doge4096/smart_home_esp8266/docs/05-testing.md

# 05 测试与分析

## 1. 测试对象

我把测试分成两个阶段：

1. **雏形设备**：只做声控开关灯，用于验证语音识别与舵机结构的可行性；
2. **改进版设备**：增加环境采集、APP 控制、自动关灯，安装到卧室做长期测试。

我把改进版在卧室实际安装并连续运行了 **4 个月**，期间保持正常生活使用，不做特殊维护。这 4 个月是集中记录的测试期；之后设备没有收起来，继续当日常设备使用，累计约 **一年半**。

## 2. 测试项目与结果

### 2.1 语音识别

| 项目 | 条件 | 结果 |
| --- | --- | --- |
| 识别距离 | 4 米以内 | 正常识别 |
| 口音 | 接近标准的普通话 | 正常识别 |
| 环境 | 室内日常噪声 | 未出现明显误触发 |

HLK-V20 的关键词在模块配置网页中设定，识别结果通过串口输出。相比我早期试用的 DFRobot 语音模块，HLK-V20 的识别准确率更高。

### 2.2 手动开关兼容

分控端只是用舵机拨动原有开关，不改变线路。测试期间我手动按压开关，不受影响；舵机停在非动作角度时也不会阻挡手动操作。

### 2.3 舵机固定与按压

| 阶段 | 固定方式 | 现象 |
| --- | --- | --- |
| 初版 | 玻璃胶直接粘舵机 | 长期使用后低概率出现粘连不牢，按压失败 |
| 改进版 | 加装专用拨片结构 + 支架 | 测试期间未再出现按压失败 |

我分析的原因是胶体老化后舵机位置偏移，加上舵机臂与开关表面摩擦力不足。拨片结构把旋转运动转为推压，减小了所需力度，同时用支架限制位移。

### 2.4 自动关灯

分控端联网获取时间，每天到达设定时间（如上午 10 点）时判断一次亮度：

- 亮度低于阈值 → 自动关灯；
- 亮度高于阈值 → 保持原状。

阈值通过 APP 下发“设置阈值”命令写入，取的是点击那一刻光敏电阻的读数。测试中我发现低成本光敏电阻的绝对精度有限，固定阈值在不同季节会误判，因此最终依靠“阈值调整 + 人工干预”来避免误动作。

### 2.5 APP 数据查看

APP 连接后可以查看两个房间的温度、湿度、可燃气体浓度。下图是实际使用时的界面：

APP 数据查看

- 卧室开了空调，温度 27.7°C、湿度 76.4%；
- 客厅未开空调，温度 28.4°C；
- 客厅刚做完饭，可燃气体读数 27，明显高于卧室的 4。

点击“刷新室内数据”可以主动请求一次上报；不操作时，主控端按 5 分钟周期定时上报，APP 会持续收到数据。

### 2.6 APP 灯具控制

控制界面按房间分组，显示当前灯的状态，支持开灯、关灯和刷新亮度。测试中我可以分别控制卧室与客厅的灯，状态显示与实际一致。

APP 灯具控制

### 2.7 长期运行

4 个月记录期间，我记录到：

- 语音开关灯正常，未影响手动开关；
- 主控端定时上报与 APP 刷新正常；
- 自动关灯按设定时间执行；
- 未出现死机或需要重启的情况。

记录期结束后，设备继续在日常使用，累计使用约 **一年半**，期间没有出现故障。后来我更换了住址，新住处没有这个需求，设备才停用。

## 3. 问题与处理

| 问题 | 原因 | 处理 |
| --- | --- | --- |
| 舵机按压失败 | 玻璃胶老化、舵机位移、摩擦力不足 | 加装专用拨片与支架，减小按压力度 |
| 自动关灯误判 | 光敏电阻精度低、季节光照变化 | APP 可调阈值，配合人工干预 |
| 主控端体积大 | STM32C8T6 核心板占用面积 | 未彻底解决，改用贴片方案可缩小 |
| 只能控制单个开关 | 一个分控对应一个舵机 | 连排开关需要多个分控，成本上升 |
| 功能单一 | 只做了灯光与空调 | 预留了扩展接口，未继续开发 |

## 4. 结果分析

系统达到了我当初设定的设计目标。回到设计初衷——住在出租屋，躺下后不想再起床关灯——这一点在一年半的日常使用中一直成立：

- 不改线路、不换面板，分控端插电即用；
- 语音、APP、自动三种控制方式可用；
- 环境数据可以远程查看，异常时标红；
- 连续记录 4 个月，后续累计使用约一年半，稳定性满足日常使用。

不足主要在结构和扩展性：主控端体积偏大，分控端只能控制单个开关，传感器精度依赖现场标定。这些问题在 [06 复盘](06-retrospective.md) 中展开。

## 5. 本章小结

我测试了语音识别、手动兼容、舵机结构、自动关灯、APP 数据与控制、长期运行六个方面。最关键的一次改进是舵机拨片结构：它把“能用”变成了“长期可用”。其余问题属于成本与结构限制，不影响核心功能。
