doge4096/smart_home_esp8266/docs/06-retrospective.md

# 06 复盘

## 0. 项目概述

**做了什么**：在不能改线路、不能换面板的出租屋里，用低成本器件做了一套可用的智能家居系统——STM32 + ESP8266 主控负责语音识别与环境采集，ESP8266 分控用舵机拨动原有开关，阿里云负责消息转发，Android APP 远程查看与控制。

**结果**：设备在卧室连续运行 4 个月完成测试记录，之后继续日常使用，累计约 **一年半**，语音、APP、定时三种控制方式都可用，期间未出现死机或故障；后来更换住址、新住处没有需求，设备才停用。

**我负责的部分**：需求、选型、电路、PCB、结构、固件、云端规则、APP 全部独立完成。

**可以核对的材料**：

- 固件源码：[firmware/](../firmware/)
- PCB 工程：[hardware/](../hardware/)
- 测试记录：[05 测试与分析](05-testing.md)
- 实物与截图：[images/](../images/)

## 1. 关键决策与结果

### 1.1 先定约束，再选方案

**决策**：动手前先给自己定了三条约束——不改线路、不换面板、不破坏墙面。

**结果**：约束直接排除了继电器方案，指向舵机拨开关；整套系统在出租屋场景里真的能用，搬家也能拆走。如果一开始选继电器改线路，后面的长期测试根本不会发生。

**证据**：[01 系统设计 3.4](01-system-design.md) 有舵机与继电器的对比表，分控板实物见 [images/sub-pcb.png](../images/sub-pcb.png)。

### 1.2 用真实环境验证，而不是实验室演示

**决策**：把改进版直接装到卧室，连续跑 4 个月，保持正常生活使用，不做特殊维护；测试记录结束后也没有收起来，继续当日常设备用。

**结果**：暴露了舵机胶粘老化导致的按压失败，推动我把固定方式改成专用拨片 + 支架。这个问题在实验室里按几次是发现不了的。设备累计使用约一年半，没有再出现故障。

**证据**：[05 测试与分析 2.3](05-testing.md) 记录了初版与改进版的对比。

### 1.3 设备解耦：云端广播代替点对点

**决策**：消息发到云端规则引擎，由规则广播到所有相关 topic，设备之间不保存彼此地址。

**结果**：新增一个分控端只需在云端加一条转发规则，不用改主控固件；APP 与分控端能同时收到同一条命令，状态更容易保持一致。

**代价**：消息会发给所有订阅者，但这个系统设备数量少，带宽可以忽略。

**证据**：[01 系统设计 4.2](01-system-design.md)；云端规则配置见 [04 云平台与 APP](04-cloud-and-app.md)。

### 1.4 按需上报

**决策**：环境数据 5 秒轮询、累计 60 次（约 5 分钟）上报一轮；亮度数据只在收到命令时上报。

**结果**：减少了无效上报，降低功耗、流量和云端消息堆积。

**证据**：上报周期写在 [03 固件设计](03-firmware.md) 的主循环里，测试数据见 [05 测试与分析 2.5](05-testing.md)。

## 2. 不足与边界

下面这些问题确实存在，其中大部分没有解决。

### 2.1 主控端体积偏大

我用了 STM32C8T6 核心板，它占用了整块板子的主要面积，外壳只能做大。这是最直观的缺点，照片里也能看出来。

**是否解决**：没有。改用贴片方案可以缩小，但当时没有条件做。

### 2.2 只能控制单个开关

一个分控对应一个舵机、一个开关。家里常见的连排双开/三开面板，需要多个分控，成本和体积都上去了。当时我也没有做多舵机联动。

**是否解决**：没有。需要多路执行器或独立的舵机驱动方案。

### 2.3 传感器精度有限

光敏电阻和 MQ-4 都是我选的低成本模拟器件，绝对精度有限。自动关灯的阈值需要按季节和房间朝向调整，否则会误判。

**是否解决**：部分解决。靠“可调阈值 + 人工干预”兜底，没有做正式标定。

### 2.4 依赖云端，断网能力有限

语音命令的链路是“主控 → 阿里云 → 分控”，断网时语音识别仍然工作，但命令发不到分控。自动关灯的判断虽然写在分控本地，但触发入口是 MQTT 消息回调，断网时同样不会执行。这是我在架构上留下的一个明显短板。

**是否解决**：没有。如果重做，我会用 ESP-NOW 或局域网 broker 做本地兜底。

### 2.5 当时没有用版本管理

毕业设计期间，我的代码只保存在本地工程里，没有用 Git 管理，也没有远程备份，两个房间的固件靠文件夹名区分。整理仓库时我把固件和 PCB 工程补了进来，但 Android APP 的源码没有找到，只能保留设计说明。

**是否解决**：已补。归档时把固件、PCB、文档纳入 Git，并修正了文档与源码不一致的地方：

| 项目 | 论文/初版文档 | 源码与实物 |
| --- | --- | --- |
| 温湿度传感器 | DHT20 | AHT20 |
| 自动关灯 | 亮度低于设定值则关灯 | 一致，但触发条件受限（见下） |
| 上报周期 | 约 3 分钟 | 5 秒 × 60 = 5 分钟 |
| APP 端定时数据 | 约 10 分钟一次 | 跟随主控 5 分钟周期 |

### 2.6 自动关灯的实现缺陷

我把自动关灯的判断写成了“早上 10 点、亮度低于阈值就关灯”，但有两个实现问题：

1. `light_adc` 只在收到 `{"data":"get"}` 时更新，关灯时我用的是最近一次查询的亮度，可能是几小时前的值；
2. 时间比较我写在了 MQTT 消息回调里，只有收到消息才会执行，不是独立定时任务。

也就是说，如果早上 10 点前后没有任何 MQTT 消息，这一天的自动关灯就不会触发；反过来，如果 10 点后第一次收到的消息是任意命令，它也会顺带触发一次判断。正确做法是用定时器在本地周期检查时间，并实时采样亮度。

**是否解决**：没有修改固件，但在归档时把问题写进了文档（本节）。这也是“没有版本管理”的代价之一：问题发现得晚。

### 2.7 APP 功能简单

我只做了数据查看和开关控制两个界面，没有历史曲线、没有多用户、没有消息推送。界面也是直接拖拽布局，没有做视觉设计。

**是否解决**：没有。属于毕设时间范围内的功能取舍。

## 3. 如果重做

### 3.1 硬件

| 方向 | 做法 | 预期收益 |
| --- | --- | --- |
| 主控小型化 | 用 ESP32-C3 单芯片替代 STM32 + ESP8266 | 降成本、降体积、少一组串口 |
| 结构可调 | 舵机支架改为 3D 打印，位置可微调 | 适配不同面板，减少现场调试 |
| 状态反馈 | 加霍尔传感器或电流检测 | 知道灯到底开没开，而不是只发命令 |
| 多开关 | 一个分控驱动多个舵机，或改用多路执行器 | 支持连排面板 |

单芯片方案也有代价：ESP32 的 ADC 精度和抗干扰不如 STM32，外设多的时候实时性也更依赖软件调度。如果重新做，我会先用 ESP32-C3 打样验证，再决定是否保留双芯片。

### 3.2 软件

如果重做，我会补上这几块：

- **本地直连**：用 ESP-NOW 或局域网 MQTT broker 做兜底，断网时语音命令仍能到达分控；
- **OTA 与配网**：加 SmartConfig/AP 配网和 OTA，换 WiFi 或改固件不用拆下来烧录；
- **历史数据**：云端规则增加转发到时序数据库，APP 增加曲线；
- **配置分离**：把 WiFi、ProductKey、DeviceSecret 放到独立配置文件，不硬编码进固件。

### 3.3 工程习惯

如果重来，我会先做这几件事：

- 从第一天就用 Git，按功能提交，保留调试记录；
- 硬件版本、PCB 工程、固件、APP 放在同一个仓库或用子模块管理；
- 测试记录（时间、现象、处理）当天写，不靠回忆；
- 关键照片和视频及时备份，实物损坏后还能追溯；
- 低保真原型先跑长期测试，很多问题只在第 3 个月出现。

## 4. 这个项目体现了什么

这个项目主要体现了下面几项能力：

| 能力 | 对应事实 | 可以核对的材料 |
| --- | --- | --- |
| 完整链路 | 需求、选型、电路、PCB、结构、固件、云平台、APP 每一层都由我实际完成 | [firmware/](../firmware/)、[hardware/](../hardware/)、[04 云平台与 APP](04-cloud-and-app.md) |
| 工程取舍 | 能说清为什么选舵机而不是继电器、为什么用广播而不是点对点、为什么低频上报 | [01 系统设计 3.4、4.2](01-system-design.md) |
| 长期验证 | 设备装到真实环境连续记录 4 个月，之后继续使用到约一年半，而不是做个演示就结束 | [05 测试与分析](05-testing.md) |
| 问题闭环 | 舵机粘连没有当成“已知问题”放着，而是改结构、再测试 | [2.3 舵机固定与按压](05-testing.md)、[02 硬件设计 4.1](02-hardware.md) |

**它不能说明的是**：大规模量产经验、EMC/安规设计、团队协作开发、复杂电源管理。这些需要在工作里补。
