doge4096/smart_home_esp8266/(list of files, drawings)

Other design files:
hardware/pcb/light.PrjPcb
hardware/pcb/PCB1.PcbDoc
hardware/pcb/PcbLib1.PcbLib
hardware/pcb/Schlib1.SchLib
hardware/pcb/Sheet1.SchDoc
