doge4096/smart_home_esp8266/(commit log)

2026-10-22 docs: 整理智能家居毕业设计文档
    - 新增系统设计、硬件、固件、云平台与 APP、测试、复盘六篇文档
    - 整理系统架构图、流程图、电路图、PCB 与实物照片
    - 补充物模型、MQTT topic 与规则引擎说明
2026-10-22 feat: 归档主控与分控固件源码、分控板 PCB 工程
    - 新增 STM32 主控端固件（卧室/客厅）
    - 新增 ESP8266 分控端固件（卧室/客厅）
    - 新增分控板 Altium 工程
    - 按真实源码修正固件、测试与复盘文档中的自动关灯逻辑、传感器型号、上报周期
    - 新增 firmware/hardware 说明文档
    - 脱敏 WiFi 凭据、ProductKey 与 DeviceSecret
2026-10-22 docs: 优化文档表述，复盘与测试改为第一人称
2026-10-22 docs: 复盘改为面试官视角，补充可验证证据与材料索引
2026-10-22 docs: 移除文档中的求职向说明与面试提示
2026-10-22 docs: 补充设备实际使用时长与项目动机
    - 说明 4 个月为集中测试记录期，之后继续日常使用，累计约一年半
    - 补充换住址后停用、期间未出现故障
    - 补充设计初衷：出租屋里不想起床关灯
2026-10-22 docs: 修正硬件成本表述
    - 整机硬件成本约 30 元，而非几百元
    - 补充与市售可联网、可语音控制设备的成本对比
2026-10-22 docs: 修正设计出发点的成本表述
    - 立项时只定「尽可能低」的成本方向，不写具体金额
    - 说明成本考虑的来源：出租屋住户不一定愿意为开关灯花几百元
